hapeet/CameraSlider/PCB/CameraSlider/render_3d.png

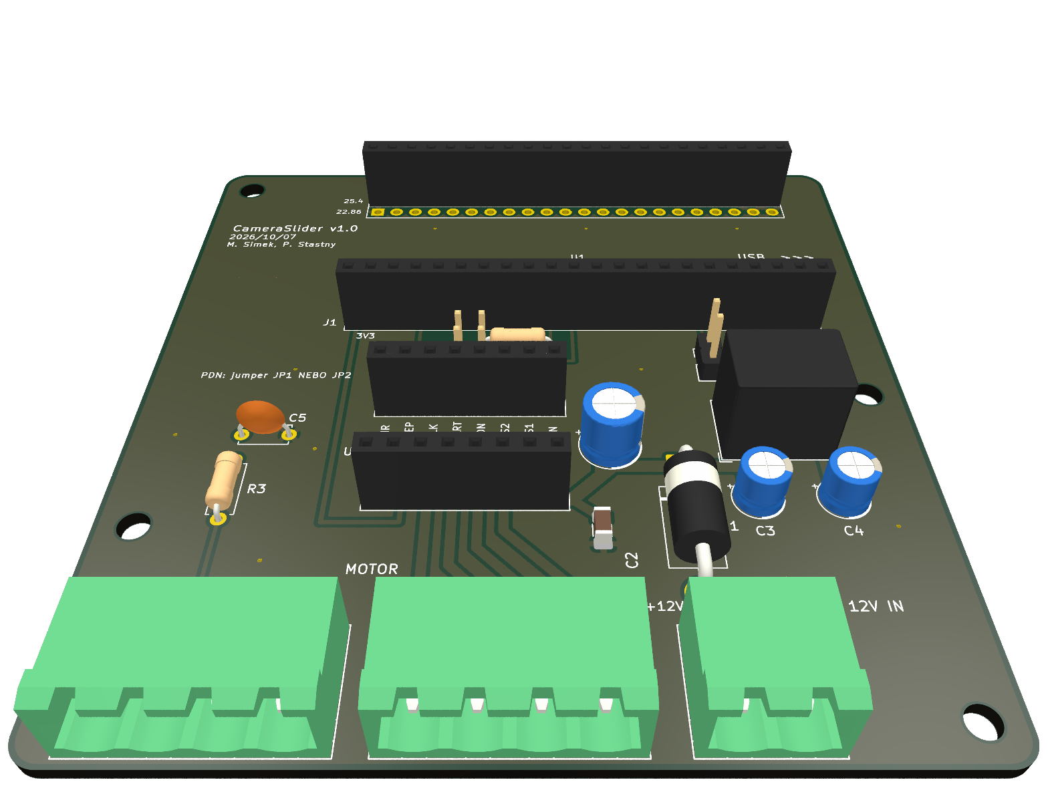
PCB/CameraSlider/render_3d.png
