hapeet/CameraSlider/PCB/CameraSlider/render_top.png

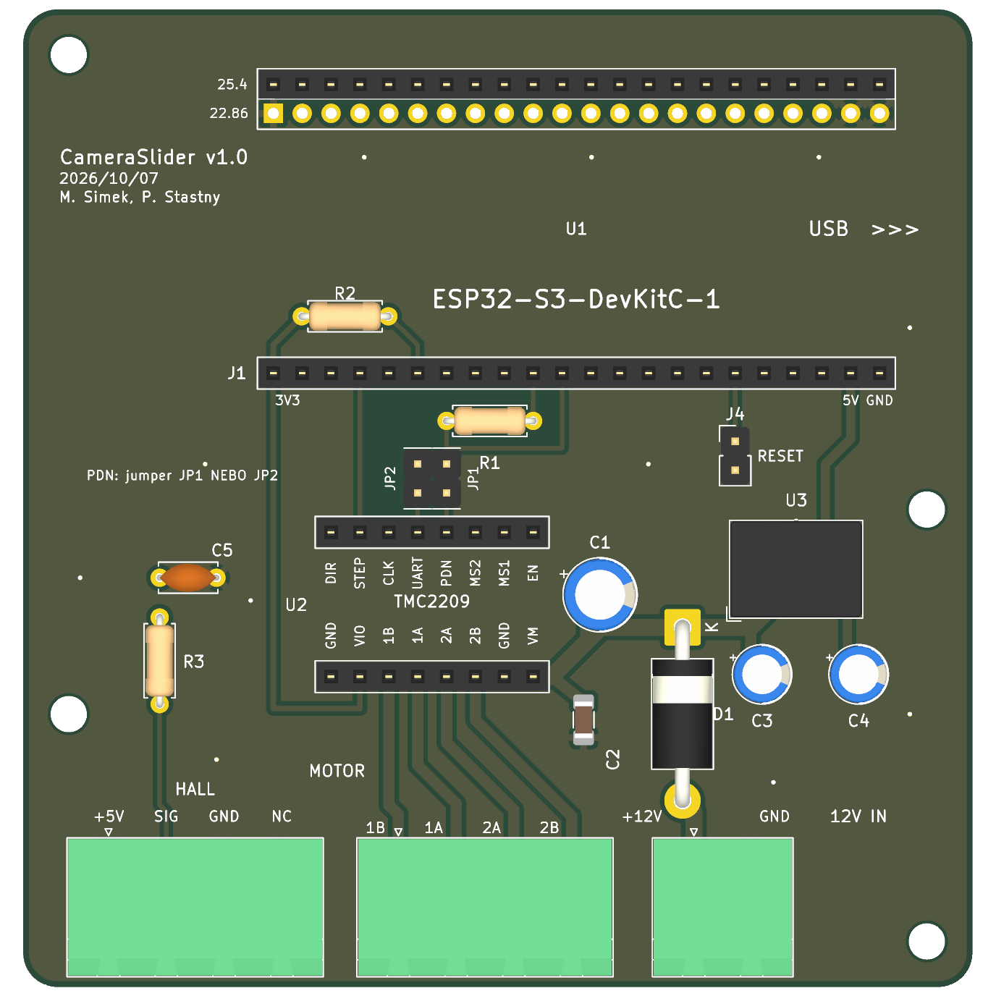
PCB/CameraSlider/render_top.png
