hapeet/CameraSlider/PCB/CameraSlider/production/CameraSlider_BOM.csv

Reference | Hodnota | Footprint | Ks
C1 | 100uF 35V | Capacitor_THT:CP_Radial_D6.3mm_P2.50mm | 1
C2 | 100nF 50V | Capacitor_SMD:C_1206_3216Metric_Pad1.33x1.80mm_HandSolder | 1
C3 | 10uF 25V | Capacitor_THT:CP_Radial_D5.0mm_P2.00mm | 1
C4 | 22uF 10V | Capacitor_THT:CP_Radial_D5.0mm_P2.00mm | 1
C5 | 1nF | Capacitor_THT:C_Disc_D5.0mm_W2.5mm_P5.00mm | 1
D1 | 1N5822 | Diode_THT:D_DO-201AD_P15.24mm_Horizontal | 1
J1 | 12V IN (Weidmuller SL 5.08/2/90) | Connector_Phoenix_MSTB:PhoenixContact_MSTBA_2,5_2-G-5,08_1x02_P5.08mm_Horizontal | 1
J2 | MOTOR (Weidmuller SL 5.08/4/90) | Connector_Phoenix_MSTB:PhoenixContact_MSTBA_2,5_4-G-5,08_1x04_P5.08mm_Horizontal | 1
J3 | HALL (Weidmuller SL 5.08/4/90) | Connector_Phoenix_MSTB:PhoenixContact_MSTBA_2,5_4-G-5,08_1x04_P5.08mm_Horizontal | 1
J4 | RESET jumper | Connector_PinHeader_2.54mm:PinHeader_1x02_P2.54mm_Vertical | 1
JP1 | PDN pin4 | CameraSlider:PinHeader_1x02_P2.54mm_Jumper | 1
JP2 | PDN pin5 | CameraSlider:PinHeader_1x02_P2.54mm_Jumper | 1
R1,R3 | 1k | Resistor_THT:R_Axial_DIN0207_L6.3mm_D2.5mm_P7.62mm_Horizontal | 2
R2 | 10k | Resistor_THT:R_Axial_DIN0207_L6.3mm_D2.5mm_P7.62mm_Horizontal | 1
U1 | ESP32-S3-DevKitC-1 N16R8 | CameraSlider:ESP32-S3-DevKitC-1_Socket | 1
U2 | TMC2209 StepperDriver | CameraSlider:TMC2209_StepStick_Socket | 1
U3 | R-78E5.0-1.0 / K7805-1000R3 | Converter_DCDC:Converter_DCDC_RECOM_R-78E-0.5_THT | 1
X1,X2 | Dutinková lišta 1x22 P2.54mm (ESP32) |  | 2
X3,X4 | Dutinková lišta 1x08 P2.54mm (TMC2209) |  | 2
X5,X6 | Jumper 2.54mm (JP1/JP2 + J4) |  | 2
