hapeet/CameraSlider/PCB/CameraSlider/production/CameraSlider_schema.pdf

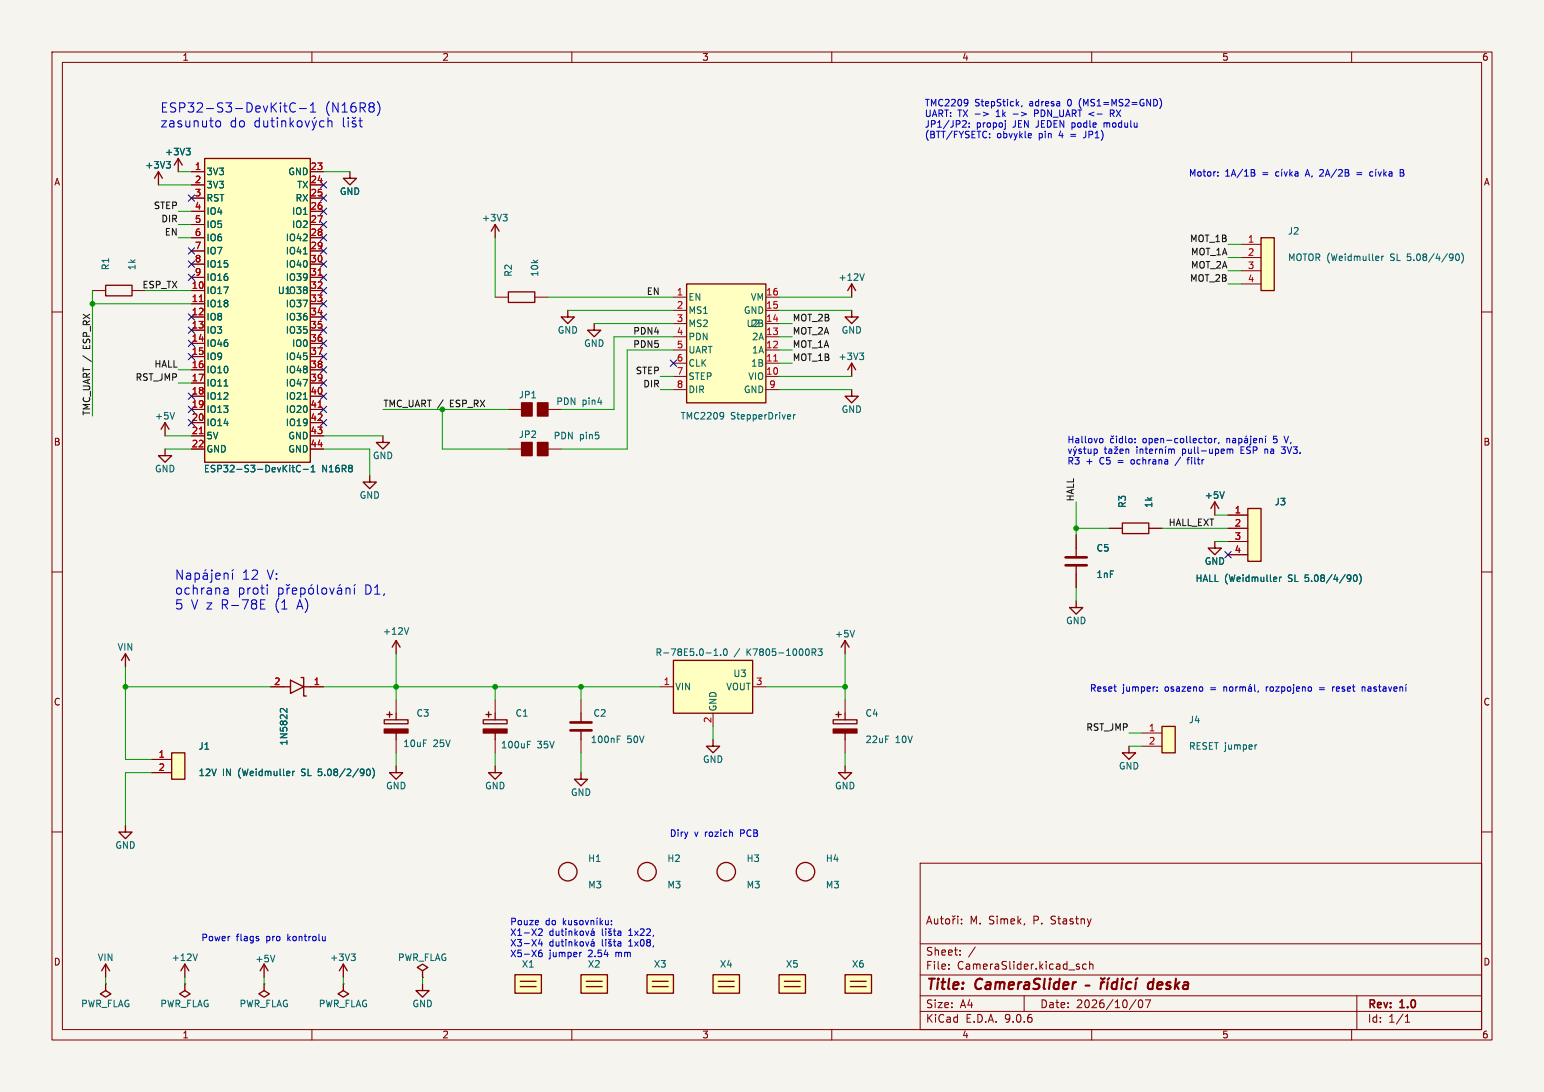
[picture p3: page 1]

(BTT/FYSETC: obvykle pin 4 = JP1)

Power flags pro kontrolu
