hapeet/CameraSlider/PCB/CameraSlider/CameraSlider.kicad_pcb

## KiCad design PCB/CameraSlider/CameraSlider.kicad_pcb (2026-10-13)

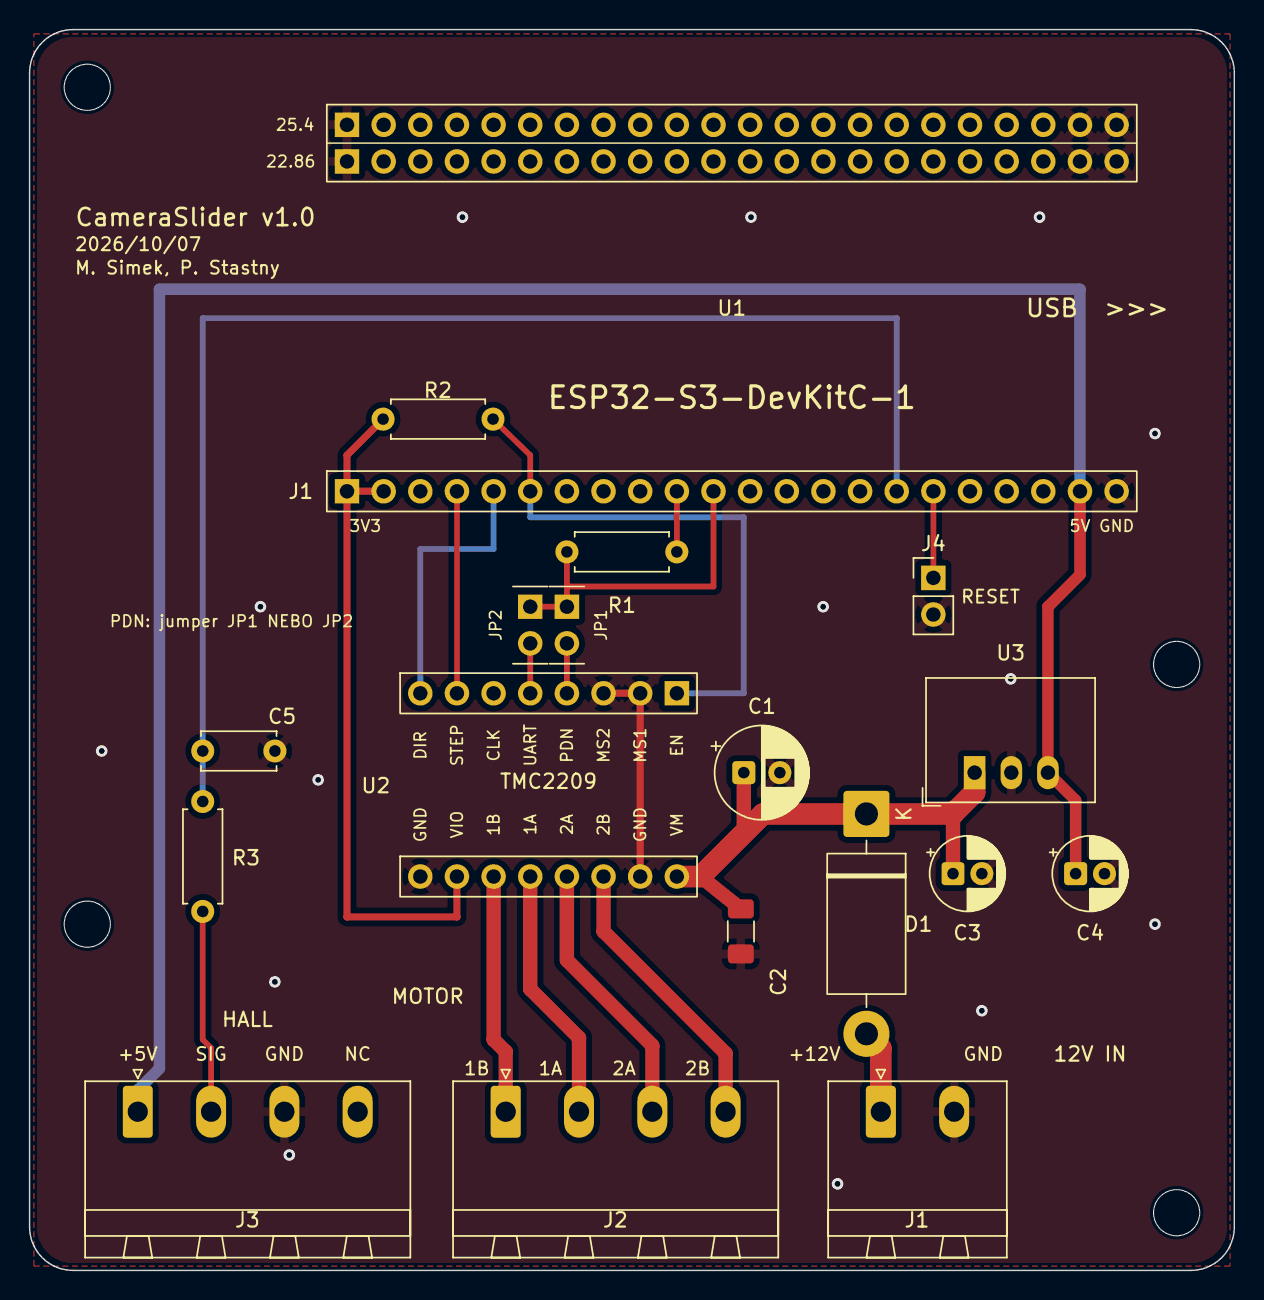
[picture p4: board CameraSlider.kicad_pcb from above]

Board: 2 copper layers, 83.5 x 86.0 mm, 22 parts (0 on the bottom side), 19 nets.

Parts:
C1: 100uF 35V; CP_Radial_D6.3mm_P2.50mm
C2: 100nF 50V; C_1206_3216Metric_Pad1.33x1.80mm_HandSolder
C3: 10uF 25V; CP_Radial_D5.0mm_P2.00mm
C4: 22uF 10V; CP_Radial_D5.0mm_P2.00mm
C5: 1nF; C_Disc_D5.0mm_W2.5mm_P5.00mm
D1: 1N5822; D_DO-201AD_P15.24mm_Horizontal
H1, H2, H3, H4: M3; MountingHole_3.2mm_M3
J1: 12V IN (Weidmuller SL 5.08/2/90); PhoenixContact_MSTBA_2,5_2-G-5,08_1x02_P5.08mm_Horizontal
J2: MOTOR (Weidmuller SL 5.08/4/90); PhoenixContact_MSTBA_2,5_4-G-5,08_1x04_P5.08mm_Horizontal
J3: HALL (Weidmuller SL 5.08/4/90); PhoenixContact_MSTBA_2,5_4-G-5,08_1x04_P5.08mm_Horizontal
J4: RESET jumper; PinHeader_1x02_P2.54mm_Vertical
JP1: PDN pin4; PinHeader_1x02_P2.54mm_Jumper
JP2: PDN pin5; PinHeader_1x02_P2.54mm_Jumper
R1, R3: 1k; R_Axial_DIN0207_L6.3mm_D2.5mm_P7.62mm_Horizontal
R2: 10k; R_Axial_DIN0207_L6.3mm_D2.5mm_P7.62mm_Horizontal
U1: ESP32-S3-DevKitC-1 N16R8; ESP32-S3-DevKitC-1_Socket
U2: TMC2209 StepperDriver; TMC2209_StepStick_Socket
U3: R-78E5.0-1.0 / K7805-1000R3; Converter_DCDC_RECOM_R-78E-0.5_THT

Connections:
+3V3: R2.1, U1.1, U1.2, U2.10
+5V: C4.1, J3.1, U1.21, U3.3 (VOUT)
+12V: C1.1, C2.1, C3.1, D1.1, U2.16, U3.1 (VIN)
/DIR: U1.5, U2.8
/EN: R2.2, U1.6, U2.1
/ESP_TX: R1.2, U1.10
/HALL: C5.1, R3.1, U1.16
/HALL_EXT: J3.2, R3.2
/MOT_1A: J2.2, U2.12
/MOT_1B: J2.1, U2.11
/MOT_2A: J2.3, U2.13
/MOT_2B: J2.4, U2.14
/PDN4: JP1.2, U2.4
/PDN5: JP2.2, U2.5
/RST_JMP: J4.1, U1.17
/STEP: U1.4, U2.7
/TMC_UART / ESP_RX: JP1.1, JP2.1, R1.1, U1.11
GND: C1.2, C2.2, C3.2, C4.2, C5.2, J1.2, J3.3, J4.2, U1.22, U1.23, U1.43, U1.44, U2.2, U2.3, U2.9, U2.15, U3.2 (GND)
VIN: D1.2, J1.1
