hapeet/CameraSlider/(commit log)

2026-10-01 Initial commit
    UI, Motor control, WiFi functions working
    [partitions.csv]
2026-10-13 hardware PCB added
    [CameraSlider-B_Cu.gbl, CameraSlider-B_Mask.gbs, CameraSlider-B_Paste.gbp, CameraSlider-B_Silkscreen.gbo, CameraSlider-Edge_Cuts.gm1, CameraSlider-F_Cu.gtl, CameraSlider-F_Mask.gts, CameraSlider-F_Paste.gtp]
